sensei-hacker/open-smart-thermostat/pcb-3d.png

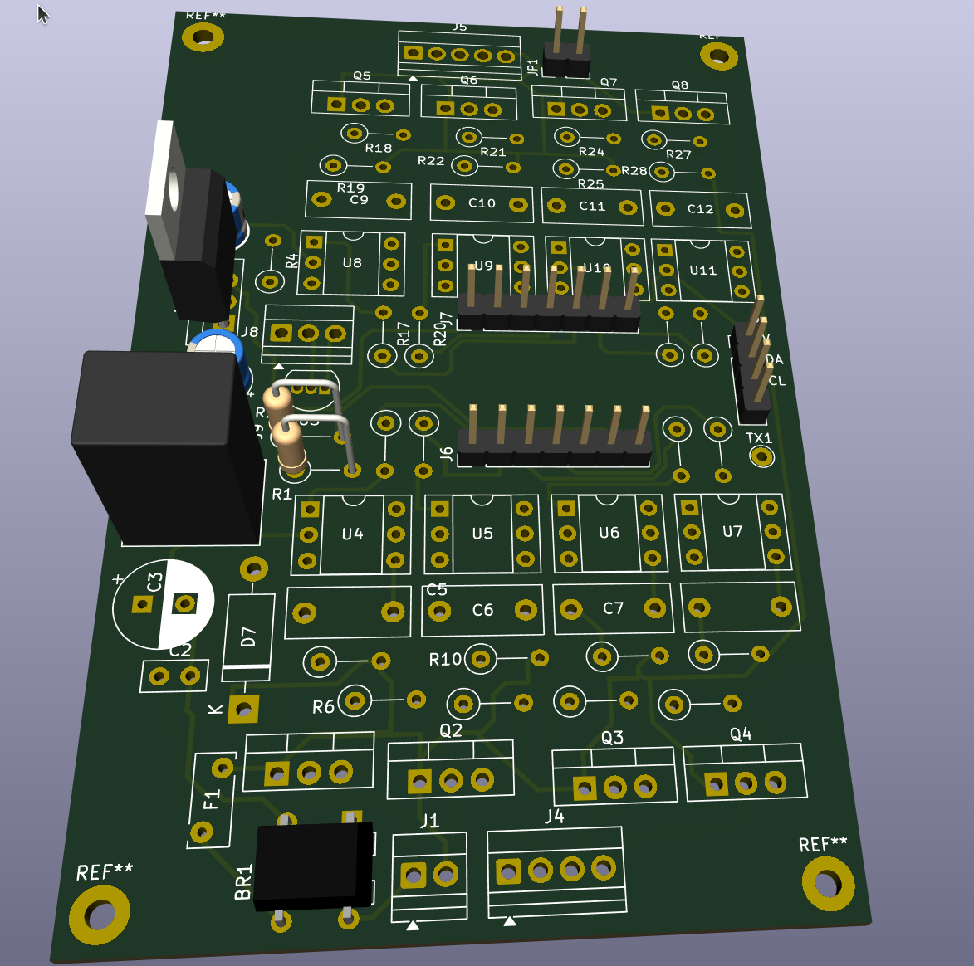
pcb-3d.png
