sensei-hacker/open-smart-thermostat/fab/gerber_back.png

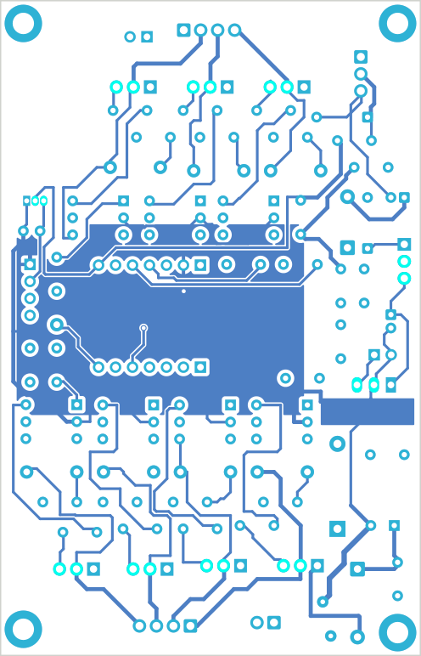
fab/gerber_back.png
