sensei-hacker/open-smart-thermostat/fab/gerber_front.png

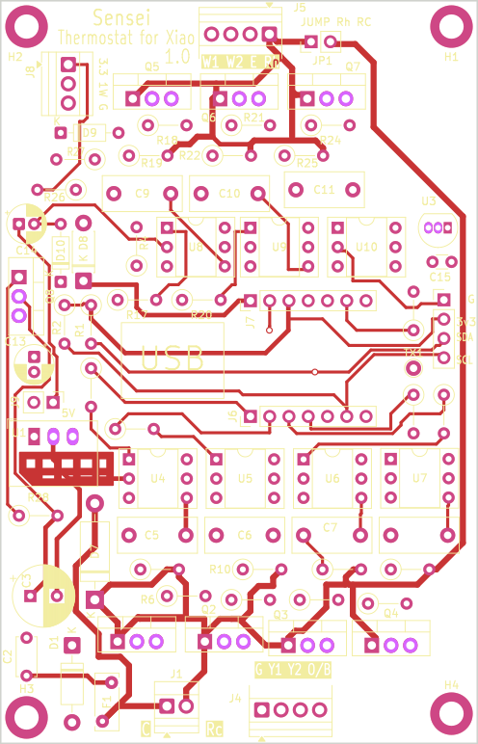
fab/gerber_front.png
