sensei-hacker/open-smart-thermostat/sim/from_schematic.png

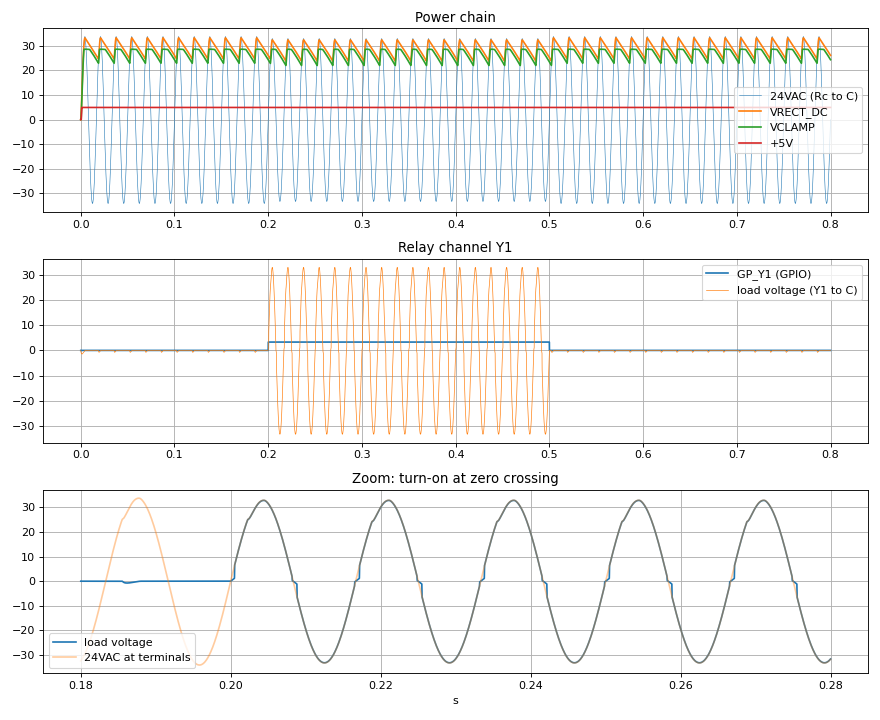
sim/from_schematic.png
