sensei-hacker/open-smart-thermostat/sim/power_chain.png

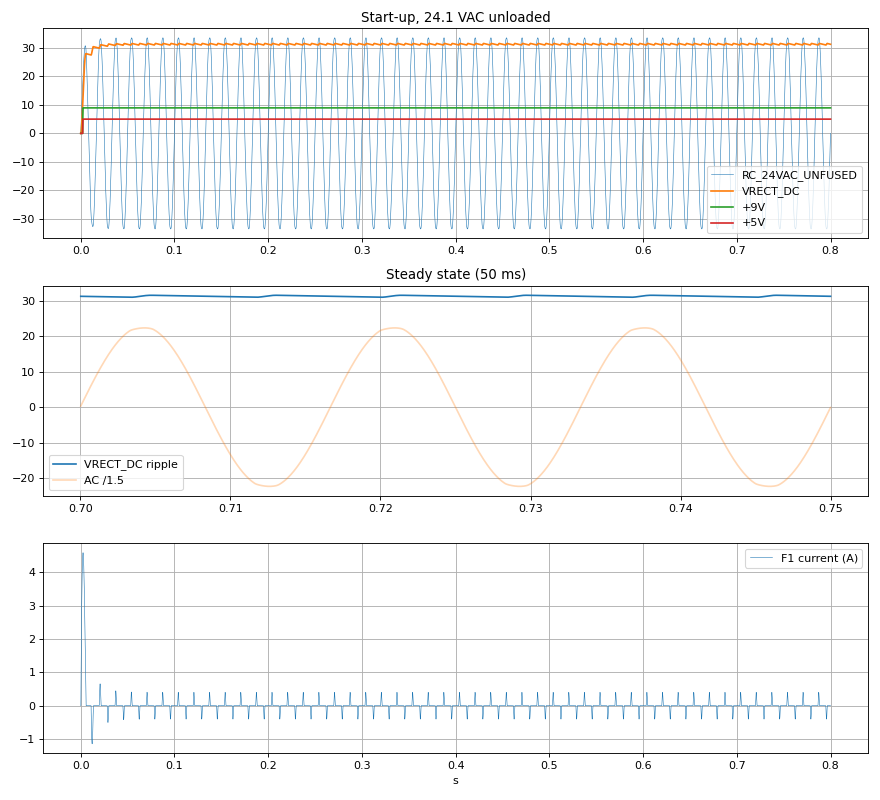
sim/power_chain.png
