sensei-hacker/open-smart-thermostat/BOM-JLC.csv

Comment | Designator | Footprint | LCSC Part #
Capacitor 100nF 100V ceramic | C2 | CAP-TH_L5.0-W2.5-P5.00 | C454377
Capacitor 100nF 50V ceramic | C15 | CAP-TH_L3.0-W1.6-P2.50 | C168753
Capacitor 100uF 63V electrolytic | C3 | CAP-TH_BD8.0-P3.50 | C88774
Capacitor 10nF 630V film | C5,C6,C7,C8,C9,C10,C11 | CAP-TH_L10.3-W4.5-P7.50 | C2927902
Capacitor 10uF 50V electrolytic | C13,C14 | CAP-TH_BD5.0-P2.00 | C88833
Diode 1N4007 rectifier 1A 1000V | D1 | DO-41_P10.16-H | C53568
Diode TVS P6KE47CA bidirectional | D7 | DO-15_P12.70-H | C8929
Diode 1N5817 Schottky 1A 20V | D8 | DO-41_P7.62-H | C698892
Diode zener 5.1V 0.5W | D9 | DO-35_P7.62-H | C895329
Diode zener 30V 0.5W | D10 | DO-35_P7.62-H | C5190031
Fuse PTC resettable 0.5A 60V | F1 | FUSE-TH_P5.10 | C208476
Terminal block 2P 2.54mm | J1 | CONN-TH_2P-P2.54_XY308 | C557685
Terminal block 3P 2.54mm | J8 | CONN-TH_3P-P2.54_XY308 | C557686
Terminal block 4P 2.54mm | J4,J5 | CONN-TH_4P-P2.54_XY308 | C915913
Male header 2P | J9,JP1 | HDR-TH_2P-P2.54-V | C32713268
Male header 4P | J3 | HDR-TH_4P-P2.54-V | C32713270
Male header 7P | J6,J7 | HDR-TH_7P-P2.54-V | C32713273
Triac BT138-600E 12A 600V | Q1,Q2,Q3,Q4,Q5,Q6,Q7 | TO-220-3_L10.0-W4.5-P2.54-T | C14796
Transistor TIP122 NPN Darlington | Q8 | TO-220-3_L10.0-W4.5-P2.54-T | C16283
Resistor 4.7K | R1,R2,R4 | RES-TH_BD2.5-L6.3-P5.08-V | C57204
Resistor 220R | R5,R6,R8,R9,R11,R12,R14,R15,R17,R18,R20,R21,R23,R24 | RES-TH_BD2.5-L6.3-P5.08-V | C57439
Resistor 100R | R7,R10,R13,R16,R19,R22,R25,R26,R27 | RES-TH_BD2.5-L6.3-P5.08-V | C57438
Resistor 2.2K | R28 | RES-TH_BD2.5-L6.3-P5.08-V | C58595
DC-DC module 5V 0.5A | U1 | SIP-3_L11.6-W7.5-P2.54 | C86735
Temperature sensor DS18B20 | U3 | TO-92-3_P1.27-INLINE | C9753
Optotriac MOC3063 zero-cross | U4,U5,U6,U7,U8,U9,U10 | DIP-6_L8.9-W6.6-P2.54-LS7.6 | C8920
