sensei-hacker/open-smart-thermostat/BOM-LCSC.csv

Comment | Designator | Footprint | Quantity | Manufacturer | Manufacturer Part # | LCSC Part # | Notes
Capacitor 100nF 100V ceramic | C2 | CAP-TH_L5.0-W2.5-P5.00 | 1 | TORCH | CT4G-1206-2X1-100V-0.1uF-K | C454377 | Leaded MLCC, 5.08mm lead pitch; fits the 5.00mm footprint
Capacitor 100nF 50V ceramic | C15 | CAP-TH_L3.0-W1.6-P2.50 | 1 | FH (Fenghua) | CT4-0805B104K500F1 | C168753 | +3V3 decoupling at U3
Capacitor 100uF 63V electrolytic | C3 | CAP-TH_BD8.0-P3.50 | 1 | Rubycon | 63PX100MEFC8X11.5 | C88774 | Polarised
Capacitor 10nF 630V film | C5,C6,C7,C8,C9,C10,C11 | CAP-TH_L10.3-W4.5-P7.50 | 7 | KNSCHA | MPP103J2J07NN22600 | C2927902 | Polypropylene snubber cap; check body fits 10.3x4.5mm outline
Capacitor 10uF 50V electrolytic | C13,C14 | CAP-TH_BD5.0-P2.00 | 2 | Rubycon | 50PX10MEFC5X11 | C88833 | Polarised. C13 is on VCLAMP (up to ~29V) so needs >=35V
Diode 1N4007 rectifier 1A 1000V | D1 | DO-41_P10.16-H | 1 | onsemi | 1N4007RLG | C53568 | Polarised
Diode TVS P6KE47CA bidirectional | D7 | DO-15_P12.70-H | 1 | RUILON | P6KE47CA | C8929 | VRWM 40.2V, VBR 44.7V. Bidirectional, either orientation
Diode 1N5817 Schottky 1A 20V | D8 | DO-41_P7.62-H | 1 | Yangjie | 1N5817 | C698892 | Polarised
Diode zener 5.1V 0.5W | D9 | DO-35_P7.62-H | 1 | onsemi | BZX79C5V1-T50A | C895329 | Polarised
Diode zener 30V 0.5W | D10 | DO-35_P7.62-H | 1 | LGE | BZX55C30 | C5190031 | Polarised. Sets the clamp voltage; BZX79-C30 equivalent
Fuse PTC resettable 0.5A 60V | F1 | FUSE-TH_P5.10 | 1 | Bourns | MF-R050 | C208476
Terminal block 2P 2.54mm | J1 | CONN-TH_2P-P2.54_XY308 | 1 | XINLAIYA | XY308-2.54-2P | C557685 | Wire entry faces board edge
Terminal block 3P 2.54mm | J8 | CONN-TH_3P-P2.54_XY308 | 1 | XINLAIYA | XY308-2.54-3P | C557686 | Wire entry faces board edge
Terminal block 4P 2.54mm | J4,J5 | CONN-TH_4P-P2.54_XY308 | 2 | XINLAIYA | XY308-2.54-4P | C915913 | Wire entry faces board edge
Male header 2P | J9,JP1 | HDR-TH_2P-P2.54-V | 2 | hanxia | HX PZ2.54-1x2P ZZ | C32713268 | Straight, 1x2, 2.54mm
Male header 4P | J3 | HDR-TH_4P-P2.54-V | 1 | hanxia | HX PZ2.54-1x4P ZZ | C32713270 | Straight, 1x4, 2.54mm
Male header 7P | J6,J7 | HDR-TH_7P-P2.54-V | 2 | hanxia | HX PZ2.54-1x7P ZZ | C32713273 | Straight, 1x7, 2.54mm. XIAO is soldered directly onto these
Triac BT138-600E 12A 600V | Q1,Q2,Q3,Q4,Q5,Q6,Q7 | TO-220-3_L10.0-W4.5-P2.54-T | 7 | WeEn | BT138-600E,127 | C14796 | Tab is MT2 and live
Transistor TIP122 NPN Darlington | Q8 | TO-220-3_L10.0-W4.5-P2.54-T | 1 | STMicroelectronics | TIP122 | C16283 | Clamp pass transistor, ~0.15W typical, no heatsink
Resistor 4.7K | R1,R2,R4 | RES-TH_BD2.5-L6.3-P5.08-V | 3 | UNI-ROYAL | MFR0W4F4701A50 | C57204 | 1/4W 1% metal film, mounted vertical
Resistor 220R | R5,R6,R8,R9,R11,R12,R14,R15,R17,R18,R20,R21,R23,R24 | RES-TH_BD2.5-L6.3-P5.08-V | 14 | UNI-ROYAL | MFR0W4F2200A50 | C57439 | 1/4W 1% metal film, mounted vertical. MOC LED and triac gate resistors
Resistor 100R | R7,R10,R13,R16,R19,R22,R25,R26,R27 | RES-TH_BD2.5-L6.3-P5.08-V | 9 | UNI-ROYAL | MFR0W4F1000A50 | C57438 | 1/4W 1% metal film, mounted vertical
Resistor 2.2K | R28 | RES-TH_BD2.5-L6.3-P5.08-V | 1 | UNI-ROYAL | MFR0W4F2201A50 | C58595 | 1/4W 1% metal film, mounted vertical
DC-DC module 5V 0.5A | U1 | SIP-3_L11.6-W7.5-P2.54 | 1 | MORNSUN | K7805-500R3 | C86735 | LM78xx pinout (Vin/GND/Vout), RECOM R-78HB footprint. C86735 is not in JLC assembly library; for JLC assembly use EVISUN K7805-500R3 C19188491 (SIP-3, 6.5-32V in)
Temperature sensor DS18B20 | U3 | TO-92-3_P1.27-INLINE | 1 | Analog Devices/Maxim | DS18B20+ | C9753 | Flat face matches silkscreen
Optotriac MOC3063 zero-cross | U4,U5,U6,U7,U8,U9,U10 | DIP-6_L8.9-W6.6-P2.54-LS7.6 | 7 | onsemi | MOC3063M | C8920
IC socket DIP-6 |  | DIP-6_L8.9-W6.6-P2.54-LS7.6 | 7 | XFCN | IC254V-12-06-0743 | C2874006 | Optional, 7 pcs for U4-U10; hand-fit, not placed by JLC
Shunt jumper cap 2.54mm |  |  | 1 | XFCN | F254D-02-065-PT-B | C2689176 | Qty 1 for JP1; hand-fit, not placed by JLC. LCSC minimum order 50
Seeed XIAO RP2040 |  |  | 1 | Seeed Studio | 102010428 |  | Buy elsewhere (Seeed, DigiKey, Mouser). Soldered onto J6/J7 headers
M5Stack Dial |  |  | 1 | M5Stack | K130 |  | Buy elsewhere (M5Stack, DigiKey, Mouser). ESP32-S3 UI
USB-C power pigtail, 2-wire |  |  | 1 |  |  |  | Buy elsewhere (Amazon/AliExpress). For J9 (pin 1 = 5V). Check red=5V with a meter; cut to length
DS18B20 waterproof probe, 3-wire |  |  | 1 |  |  |  | Buy elsewhere. Optional, for J8: J8.1 3V3, J8.2 DQ, J8.3 GND. Verify wire colours
AHT20 or SHT31 humidity module (3.3V I2C) |  |  | 1 |  |  |  | Buy elsewhere (Adafruit, AliExpress). Optional, for J3 (GND/3V3/SDA/SCL). Mount on a short cable away from the regulators
 |  |  | 84
