sensei-hacker/open-smart-thermostat/thermostat.kicad_pcb

## KiCad design thermostat.kicad_pcb (2026-10-26)

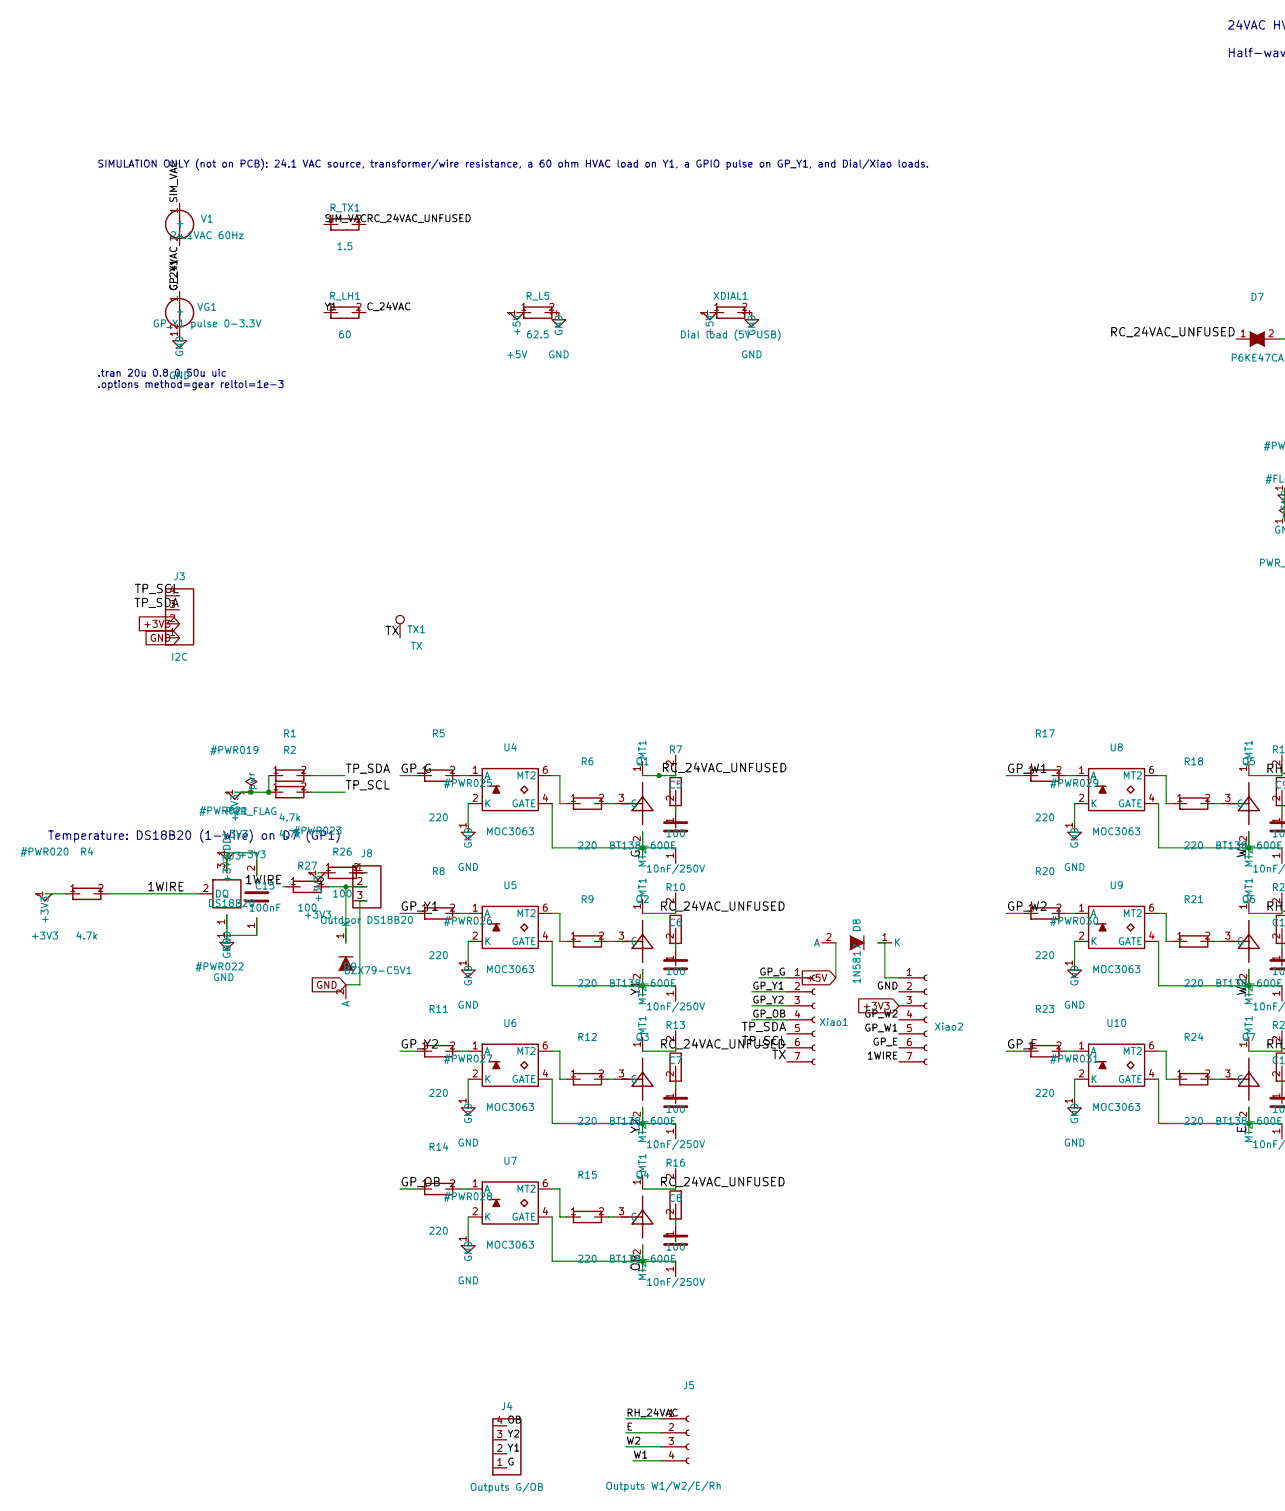
[picture p6: schematic thermostat.kicad_sch, HVAC Thermostat - Raspberry Pi Pico 2 W, part in row 1, column 1]

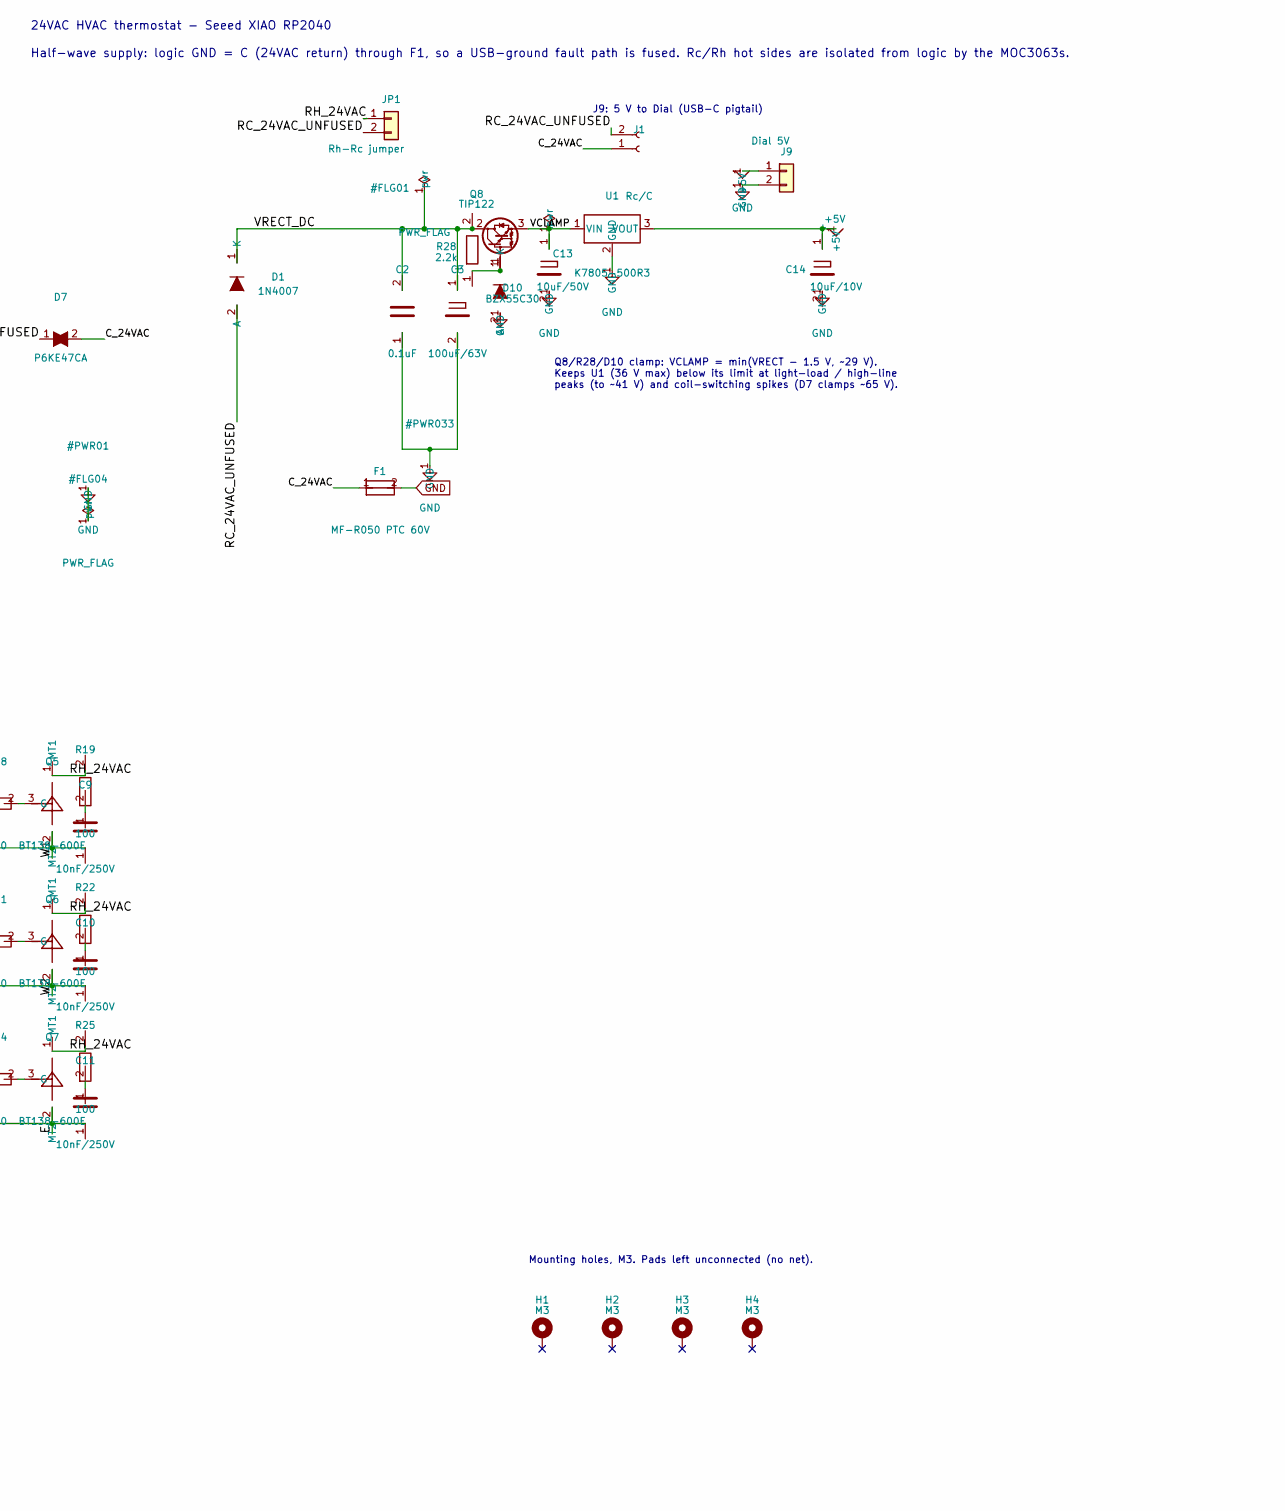
[picture p7: schematic thermostat.kicad_sch, HVAC Thermostat - Raspberry Pi Pico 2 W, part in row 1, column 2]

Parts:
C2: 0.1uF; C_Disc_D5.0mm_W2.5mm_P5.00mm
C3: 100uF/63V; CP_Radial_D8.0mm_P3.50mm
C5, C6, C7, C8, C9, C10, C11: 10nF/250V; C_Rect_L10.3mm_W4.5mm_P7.50mm_MKS4
C13: 10uF/50V; CP_Radial_D5.0mm_P2.00mm
C14: 10uF/10V; CP_Radial_D5.0mm_P2.00mm
C15: 100nF; C_Disc_D3.0mm_W1.6mm_P2.50mm
D1: 1N4007; D_DO-41_SOD81_P10.16mm_Horizontal
D7: P6KE47CA; D_DO-15_P12.70mm_Horizontal
D8: 1N5817; D_DO-41_SOD81_P7.62mm_Horizontal
D9: BZX79-C5V1; D_DO-35_SOD27_P7.62mm_Horizontal
D10: BZX55C30; D_DO-35_SOD27_P7.62mm_Horizontal
F1: MF-R050 PTC 60V; Fuse_Bourns_MF-RHT050
H1, H2, H3, H4: M3; MountingHole_3.2mm_M3_DIN965_Pad
J1: Rc/C; TerminalBlock_Xinya_XY308-2.54-2P_1x02_P2.54mm_Horizontal
J3: I2C; PinHeader_1x04_P2.54mm_Vertical
J4: Outputs G/OB; TerminalBlock_Xinya_XY308-2.54-4P_1x04_P2.54mm_Horizontal
J5: Outputs W1/W2/E/Rh; TerminalBlock_Xinya_XY308-2.54-4P_1x04_P2.54mm_Horizontal
J6: Xiao1; PinHeader_1x07_P2.54mm_Vertical
J7: Xiao2; PinHeader_1x07_P2.54mm_Vertical
J8: Outdoor DS18B20; TerminalBlock_Xinya_XY308-2.54-3P_1x03_P2.54mm_Horizontal
J9: Dial 5V; PinHeader_1x02_P2.54mm_Vertical
JP1: Rh-Rc jumper; PinHeader_1x02_P2.54mm_Vertical
Q1, Q2, Q3, Q4, Q5, Q6, Q7: BT138-600E; TO-220-3_Vertical
Q8: TIP122; TO-220-3_Vertical
R1, R2, R4: 4.7k; R_Axial_DIN0207_L6.3mm_D2.5mm_P5.08mm_Vertical
R5, R6, R8, R9, R11, R12, R14, R15, R17, R18, R20, R21, R23, R24: 220; R_Axial_DIN0207_L6.3mm_D2.5mm_P5.08mm_Vertical
R7, R10, R13, R16, R19, R22, R25, R26, R27: 100; R_Axial_DIN0207_L6.3mm_D2.5mm_P5.08mm_Vertical
R28: 2.2k; R_Axial_DIN0207_L6.3mm_D2.5mm_P5.08mm_Vertical
R_L5: 62.5
R_LH1: 60
R_TX1: 1.5
TX1: TX; TestPoint_THTPad_D2.0mm_Drill1.0mm
U1: K7805-500R3; Converter_DCDC_RECOM_R-78HB-0.5_THT
U3: DS18B20; TO-92_Inline
U4, U5, U6, U7, U8, U9, U10: MOC3063; DIP-6_W7.62mm_Socket
V1: 24.1VAC 60Hz
VG1: GP_Y1 pulse 0-3.3V
XDIAL1: Dial load (5V USB)

Connections:
+3V3: C15.2, J3.2, J7.3, R1.1, R2.1, R4.1, R26.1, U3.3 (VDD)
+5V: C14.1 (+_1), D8.2 (A), J9.1, R_L5.1, U1.3 (VOUT), XDIAL1.1
/1WIRE: J7.7, R4.2, R27.1, U3.2 (DQ)
/C_24VAC: D7.2, F1.1, J1.1, R_LH1.2, V1.2 (-)
/E: C11.1, J5.2, Q7.2 (MT2), U10.4 (GATE)
/G: C5.1, J4.1, Q1.2 (MT2), U4.4 (GATE)
/GP_E: J7.6, R23.1
/GP_G: J6.1, R5.1
/GP_OB: J6.4, R14.1
/GP_W1: J7.5, R17.1
/GP_W2: J7.4, R20.1
/GP_Y1: J6.2, R8.1, VG1.1 (+)
/GP_Y2: J6.3, R11.1
/OB: C8.1, J4.4, Q4.2 (MT2), U7.4 (GATE)
/RC_24VAC_UNFUSED: D1.2 (A), D7.1, J1.2, JP1.2, Q1.1 (MT1), Q2.1 (MT1), Q3.1 (MT1), Q4.1 (MT1), R7.2, R10.2, R13.2, R16.2, R_TX1.2
/RH_24VAC: J5.1, JP1.1, Q5.1 (MT1), Q6.1 (MT1), Q7.1 (MT1), R19.2, R22.2, R25.2
/TP_SCL: J3.4, J6.6, R2.2
/TP_SDA: J3.3, J6.5, R1.2
/TX: J6.7, TX1.1 (1_1)
/VCLAMP: C13.1 (+_1), Q8.3 (E), U1.1 (VIN)
/VRECT_DC: C2.2, C3.1 (+_1), D1.1 (K), Q8.2 (C), R28.2
/W1: C9.1, J5.4, Q5.2 (MT2), U8.4 (GATE)
/W2: C10.1, J5.3, Q6.2 (MT2), U9.4 (GATE)
/Y1: C6.1, J4.2, Q2.2 (MT2), R_LH1.1, U5.4 (GATE)
/Y2: C7.1, J4.3, Q3.2 (MT2), U6.4 (GATE)
GND: C2.1, C3.2, C13.2, C14.2, C15.1, D9.2 (A), D10.2 (A), F1.2, J3.1, J7.2, J8.3, J9.2, R_L5.2, U1.2 (GND), U3.1 (GND), U4.2 (K), U5.2 (K), U6.2 (K), U7.2 (K), U8.2 (K), U9.2 (K), U10.2 (K), VG1.2 (-), XDIAL1.2
unnamed: C5.2, R7.1
unnamed: C6.2, R10.1
unnamed: C7.2, R13.1
unnamed: C8.2, R16.1
unnamed: C9.2, R19.1
unnamed: C10.2, R22.1
unnamed: C11.2, R25.1
unnamed: D8.1 (K), J7.1
unnamed: D9.1 (K), J8.2, R27.2
unnamed: D10.1 (K), Q8.1 (B), R28.1
unnamed: J8.1, R26.2
unnamed: Q1.3 (G), R6.2
unnamed: Q2.3 (G), R9.2
unnamed: Q3.3 (G), R12.2
unnamed: Q4.3 (G), R15.2
unnamed: Q5.3 (G), R18.2
unnamed: Q6.3 (G), R21.2
unnamed: Q7.3 (G), R24.2
unnamed: R_TX1.1, V1.1 (+)
unnamed: R5.2, U4.1 (A)
unnamed: R6.1, U4.6 (MT2)
unnamed: R8.2, U5.1 (A)
unnamed: R9.1, U5.6 (MT2)
unnamed: R11.2, U6.1 (A)
unnamed: R12.1, U6.6 (MT2)
unnamed: R14.2, U7.1 (A)
unnamed: R15.1, U7.6 (MT2)
unnamed: R17.2, U8.1 (A)
unnamed: R18.1, U8.6 (MT2)
unnamed: R20.2, U9.1 (A)
unnamed: R21.1, U9.6 (MT2)
unnamed: R23.2, U10.1 (A)
unnamed: R24.1, U10.6 (MT2)

Notes on the sheet:
SIMULATION ONLY (not on PCB): 24.1 VAC source, transformer/wire resistance, a 60 ohm HVAC load on Y1, a GPIO pulse on GP_Y1, and Dial/Xiao loads.
Half-wave supply: logic GND = C (24VAC return) through F1, so a USB-ground fault path is fused. Rc/Rh hot sides are isolated from logic by the MOC3063s.
Mounting holes, M3. Pads left unconnected (no net).
J9: 5 V to Dial (USB-C pigtail)
Temperature: DS18B20 (1-Wire) on D7 (GP1)
24VAC HVAC thermostat - Seeed XIAO RP2040
.tran 20u 0.8 0 50u uic .options method=gear reltol=1e-3
Q8/R28/D10 clamp: VCLAMP = min(VRECT - 1.5 V, ~29 V). Keeps U1 (36 V max) below its limit at light-load / high-line peaks (to ~41 V) and coil-switching spikes (D7 clamps ~65 V).

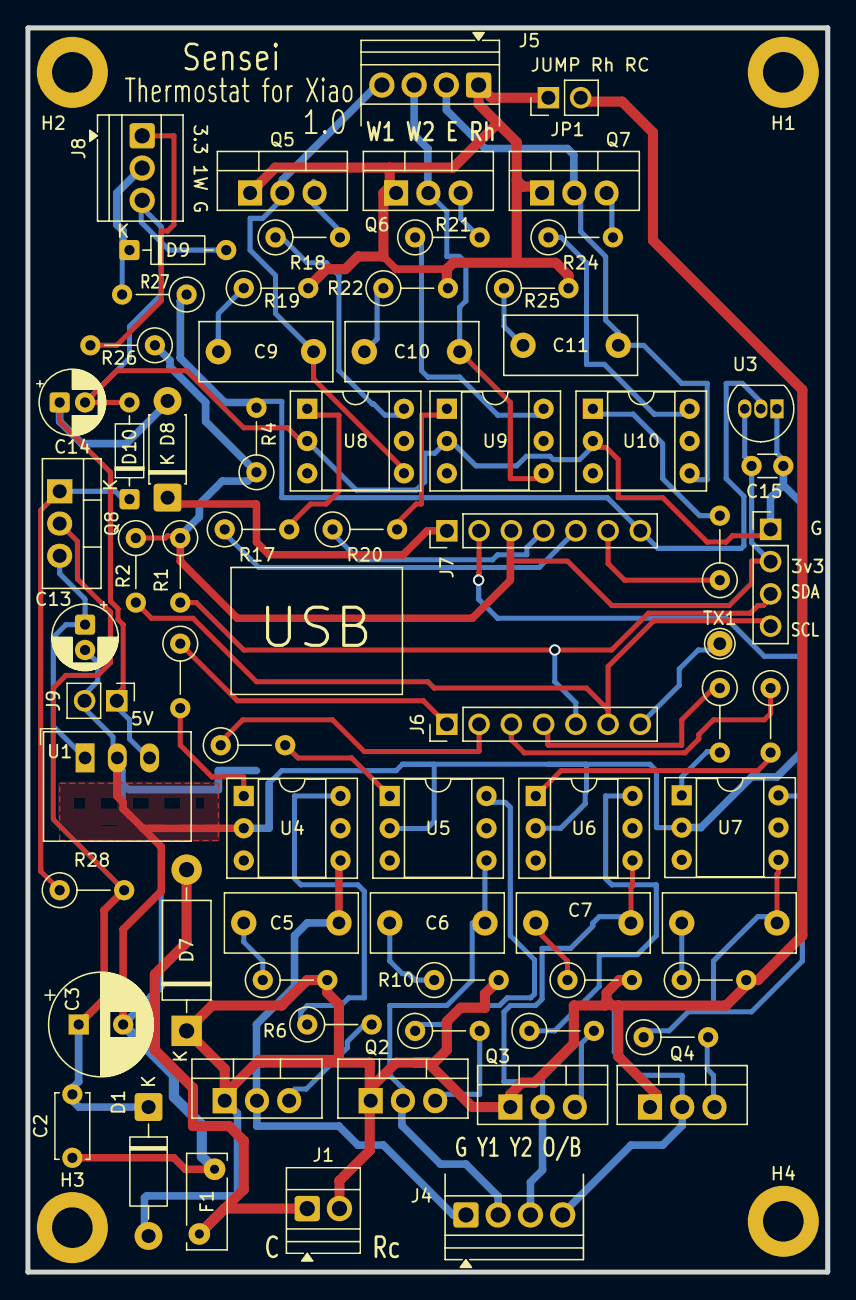
[picture p8: board thermostat.kicad_pcb from above]

Board: 2 copper layers, 63.0 x 98.0 mm, 76 parts (0 on the bottom side), 58 nets.
