sensei-hacker/open-smart-thermostat/(commit log)

2026-10-25 Initial commit: 24 VAC thermostat board (XIAO RP2040 + M5Stack Dial)
    KiCad 10 schematic and PCB, JLCPCB fab files, LCSC BOM, assembly and
    test guide, design reviews, and ngspice simulation scripts.
    Claude-Session: https://claude.ai/code/session_01E7T4v2apyDnHDNPi6eHwQU
    [9v-buck-modules.csv, BOM-LCSC.csv, BOM.csv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]
2026-10-26 Update for JLC order: C2 5 mm, U3 power fix, new BOMs, 1.1 mm header holes
    - C2 footprint is now 5.00 mm pitch; fab files and CPL regenerated
    (fab zip 2026-10-25 matches the boards ordered from JLC)
    - Schematic: move U3's +3V3 and GND symbols back onto its wires
    - BOM-LCSC.csv reformatted (Comment/Designator/Footprint/.../Notes);
    new BOM-JLC.csv and BOM-NextPCB.xls (one row per part)
    - PCB: header drills (J3, J6, J7, J9, JP1) 1.0 -> 1.1 mm for the next
    revision; fab files were NOT regenerated for this change
    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
    [BOM-JLC.csv, BOM-LCSC.csv, BOM-NextPCB.xls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]
